cepiment/FisheriesNET/README.md

# FisheriesNET
Low Cost Solar Powered GPS Trackers
