cepiment/FisheriesNET/Schematics/LayoutView.PNG

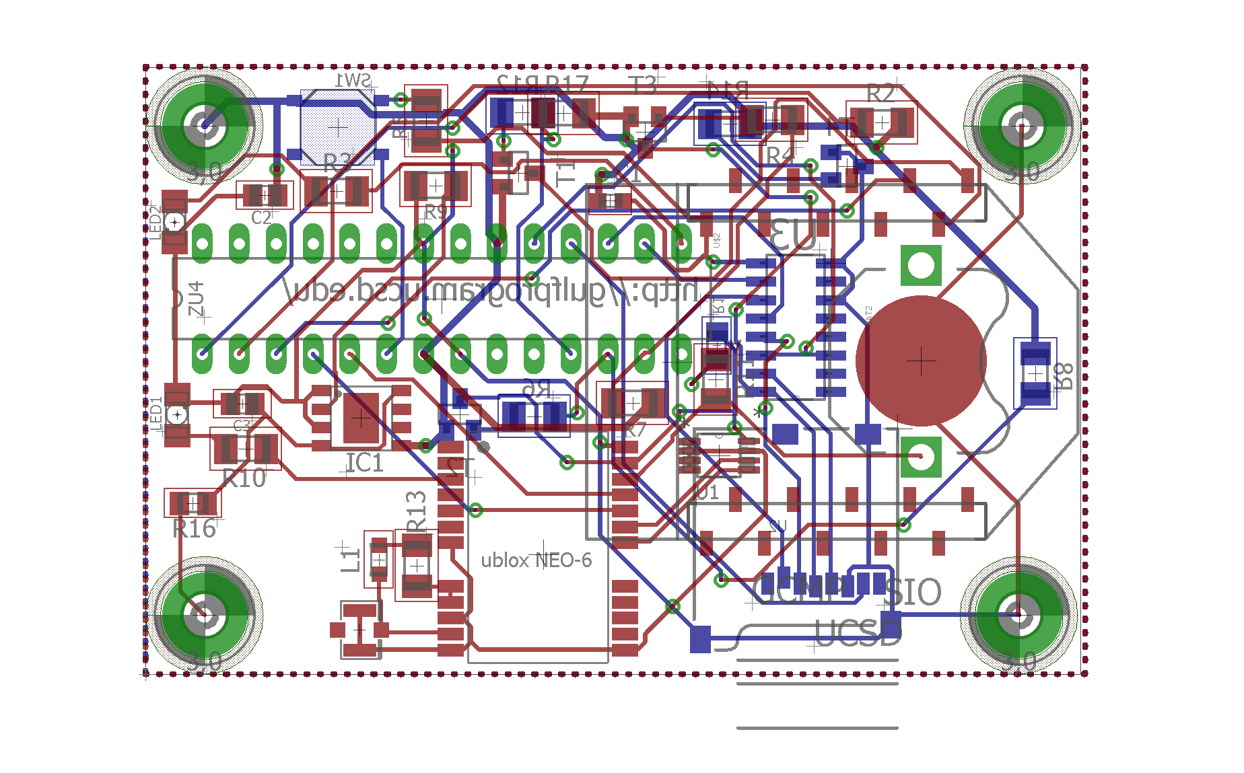
Schematics/LayoutView.PNG
