cepiment/FisheriesNET/Schematics/Schematic.PNG

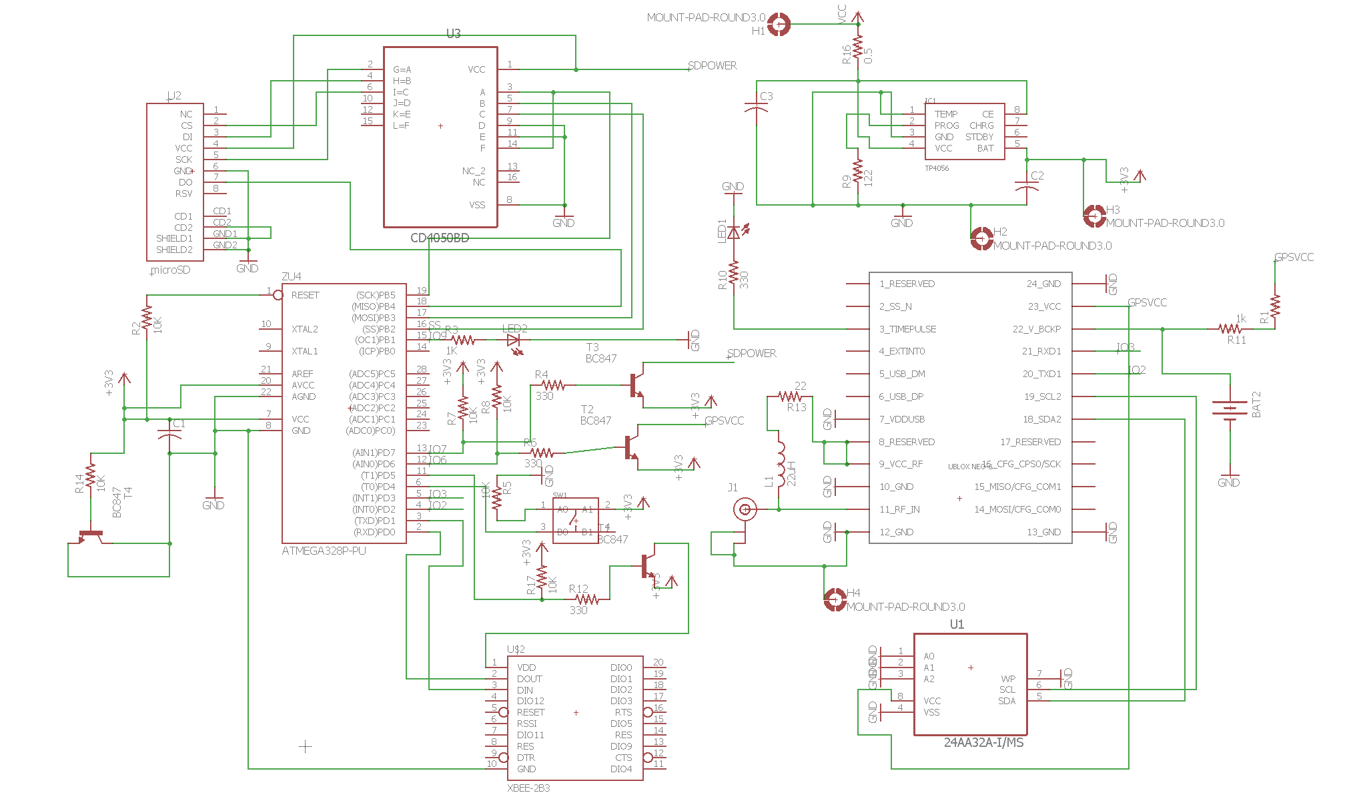
Schematics/Schematic.PNG
