cepiment/FisheriesNET/Schematics/janaury20.brd

## EAGLE design Schematics/janaury20.brd (2016-08-30)

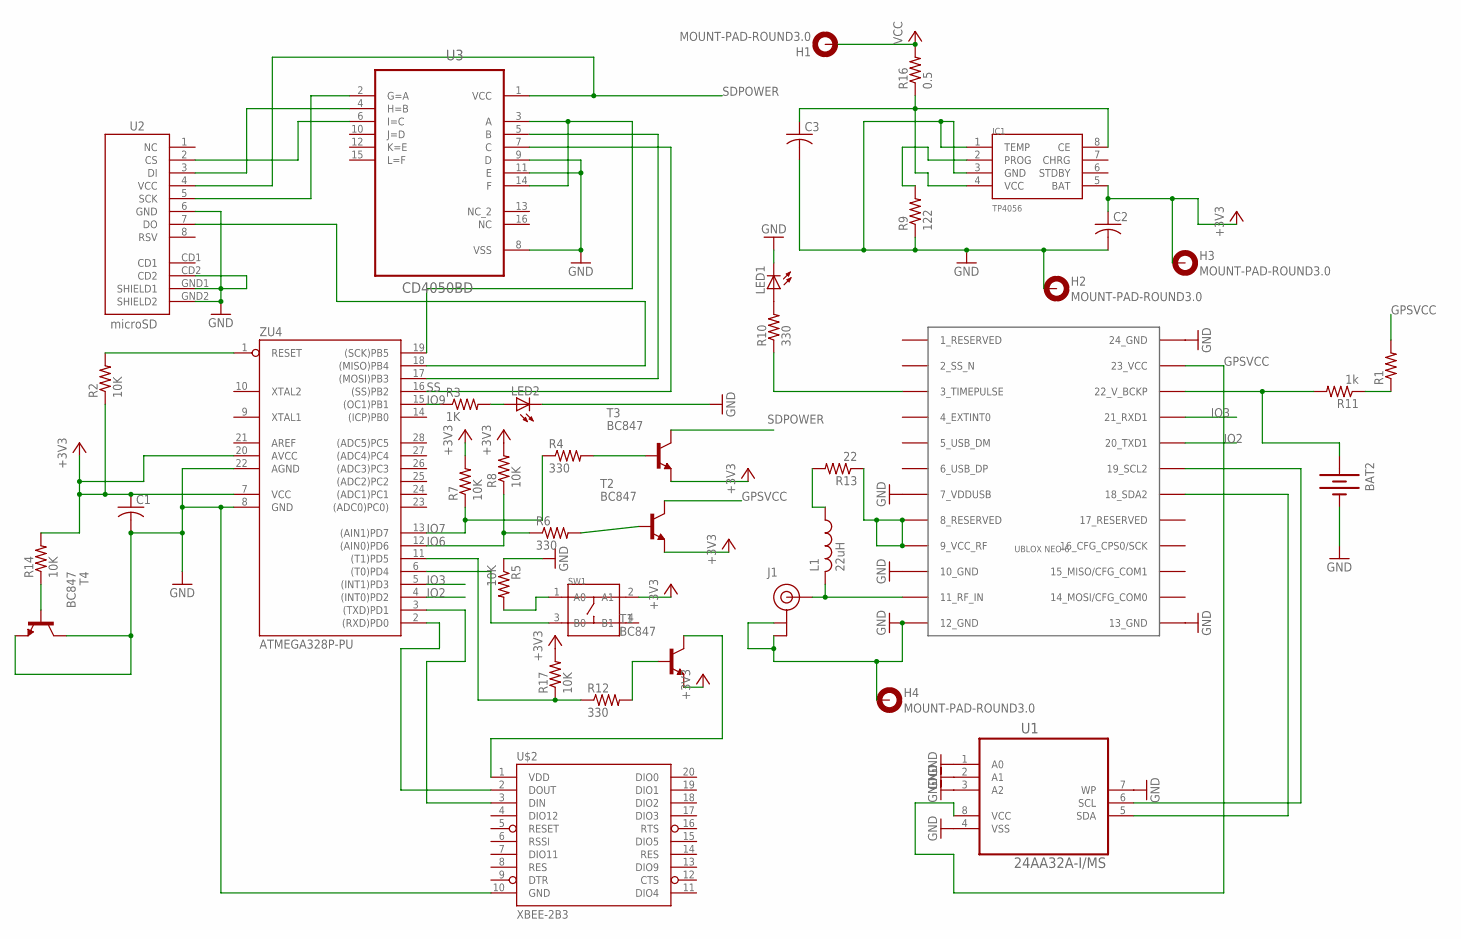
[picture p6: schematic janaury20.sch]

Parts:
BAT2: BATTERY12PTH; BATTCON_12MM_PTH
C1: C-USC1608; C1608
C2, C3: C-USC2012; C2012
H1, H2, H3, H4: MOUNT-PAD-ROUND3.0; 3,0-PAD
IC1: TP4056; SOP-8
J1: U.FL
L1: 22uH; L2012C
LED1, LED2: LEDSMT1206; 1206
R1: R-US_R0805; R0805
R2, R5, R7, R8, R14, R17: 10K; M3216
R3: 1K; M3216
R4, R6, R10, R12: 330; M3216
R9: 122; M3216
R11: 1k; M3216
R13: 22; M3216
R16: 0.5; M2012
SW1: SMD-BUTTON(4P-5.2X5.2X1.5MM-SKQGAKE010)-SKQGAKE010; SW4-SMD-5.2X5.2X1.5MM
T1, T2, T3, T4: BC847; SOT23
U1: 24AA32A-I/MS; SOP65P490X110-8N
U2: microSD; MICRO-SD-SOCKET-PP
U3: CD4050BD; SOIC127P600X175-16N
U$1: UBLOX_NEO-6; UBLOX_NEO-6P
U$2: XBEE-2B3; XBEE-SMD
ZU4: ATMEGA328P-PU; DIL28-3

Connections:
+3V3: C1.1, C2.1, H3.B3,0, IC1.5 (BAT), R2.1, R7.2, R8.2, R14.2, R17.2, SW1.2 (A1), T1.2 (E), T2.2 (E), T3.2 (E), ZU4.7 (VCC), ZU4.20 (AVCC)
CS: U2.2 (CS), U3.6 (I=C)
GND: BAT2.GND (-), C1.2, C2.2, C3.2, H2.B3,0, H4.B3,0, IC1.1 (TEMP), IC1.3 (GND), J1.P$1 (GND), J1.P$2 (GND), LED1.C, LED2.C, R5.1, R9.1, T4.2 (E), T4.3 (C), U1.1 (A0), U1.2 (A1), U1.3 (A2), U1.4 (VSS), U1.7 (WP), U2.6 (GND), U2.CD2, U2.GND1 (SHIELD1), U2.GND2 (SHIELD2), U3.8 (VSS), U3.9 (D), U3.11 (E), U$1.7_VDDUSB, U$1.10_GND, U$1.12_GND, U$1.13_GND, U$1.24_GND, U$2.10 (GND), ZU4.8 (GND), ZU4.22 (AGND)
GPSVCC: R1.2, T2.3 (C), U1.8 (VCC), U$1.23_VCC
IO2: U$1.20_TXD1, ZU4.4 ((INT0)PD2)
IO3: U$1.21_RXD1, ZU4.5 ((INT1)PD3)
IO6: R6.1, R8.1, ZU4.12 ((AIN0)PD6)
IO7: R4.1, R7.1, ZU4.13 ((AIN1)PD7)
IO9: R3.1, ZU4.15 ((OC1)PB1)
MOSI: U3.5 (B), ZU4.17 ((MOSI)PB3)
unnamed: U2.7 (DO), ZU4.18 ((MISO)PB4)
unnamed: LED2.A, R3.2
unnamed: LED1.A, R10.2
unnamed: R5.2, SW1.1 (A0)
unnamed: SW1.3 (B0), ZU4.6 ((T0)PD4)
unnamed: R4.2, T3.1 (B)
unnamed: R6.2, T2.1 (B)
unnamed: U1.6 (SCL), U$1.19_SCL2
unnamed: R12.1, R17.1, ZU4.11 ((T1)PD5)
unnamed: L1.1, R13.2
unnamed: U2.3 (DI), U3.4 (H=B)
unnamed: R12.2, T1.1 (B)
unnamed: R13.1, U$1.8_RESERVED, U$1.9_VCC_RF
unnamed: R14.1, T4.1 (B)
unnamed: J1.P$3 (SIGNAL), L1.2, U$1.11_RF_IN
unnamed: BAT2.VCC@1 (+), R11.2, U$1.22_V_BCKP
unnamed: U1.5 (SDA), U$1.18_SDA2
unnamed: R1.1, R11.1
unnamed: IC1.2 (PROG), R9.2
unnamed: U$2.2 (DOUT), ZU4.2 ((RXD)PD0)
unnamed: U$2.3 (DIN), ZU4.3 ((TXD)PD1)
unnamed: C3.1, IC1.4 (VCC), IC1.8 (CE), R16.1
unnamed: T1.3 (C), U$2.1 (VDD)
RESET: R2.2, ZU4.1 (RESET)
SCK: U3.3 (A), U3.14 (F), ZU4.19 ((SCK)PB5)
SCK1: U2.5 (SCK), U3.2 (G=A)
SCK2: R10.1, U$1.3_TIMEPULSE
SDPOWER: T3.3 (C), U2.4 (VCC), U3.1 (VCC)
SS: U3.7 (C), ZU4.16 ((SS)PB2)
VCC: H1.B3,0, R16.2

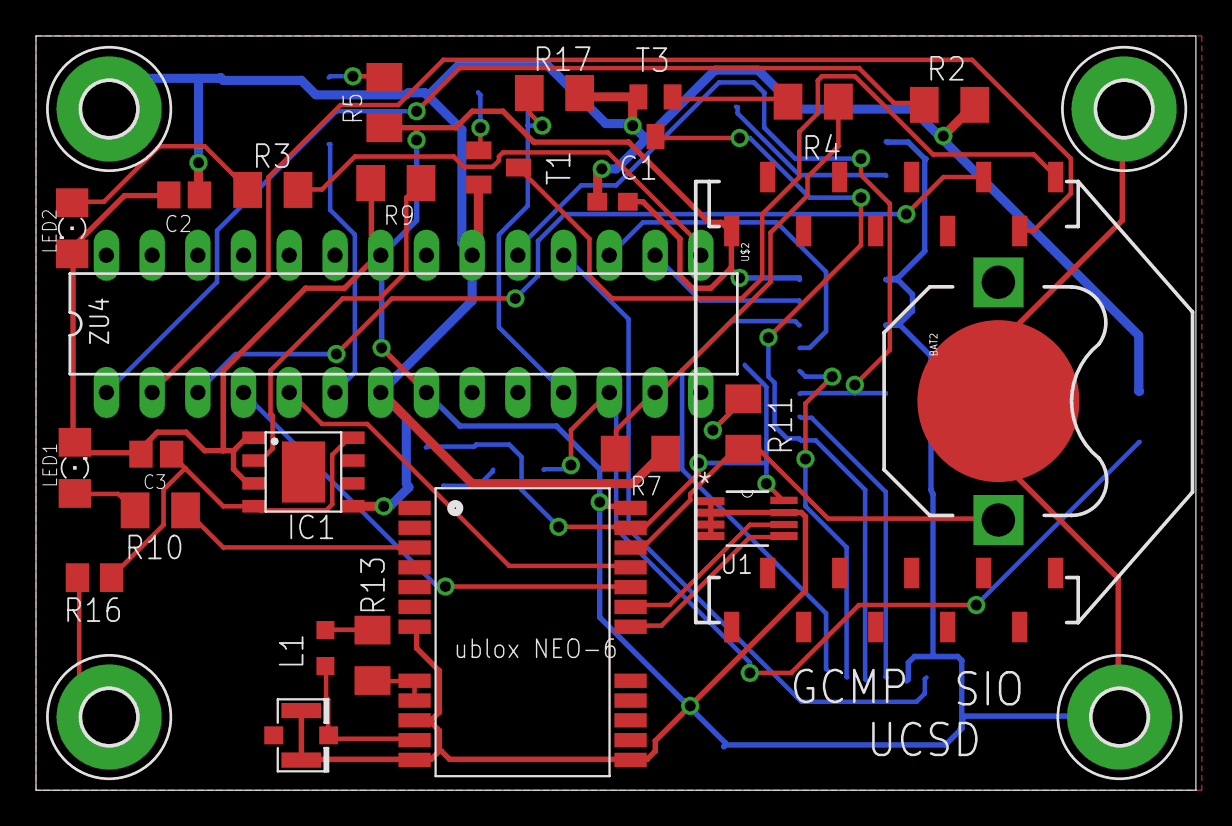
[picture p7: board janaury20.brd from above]

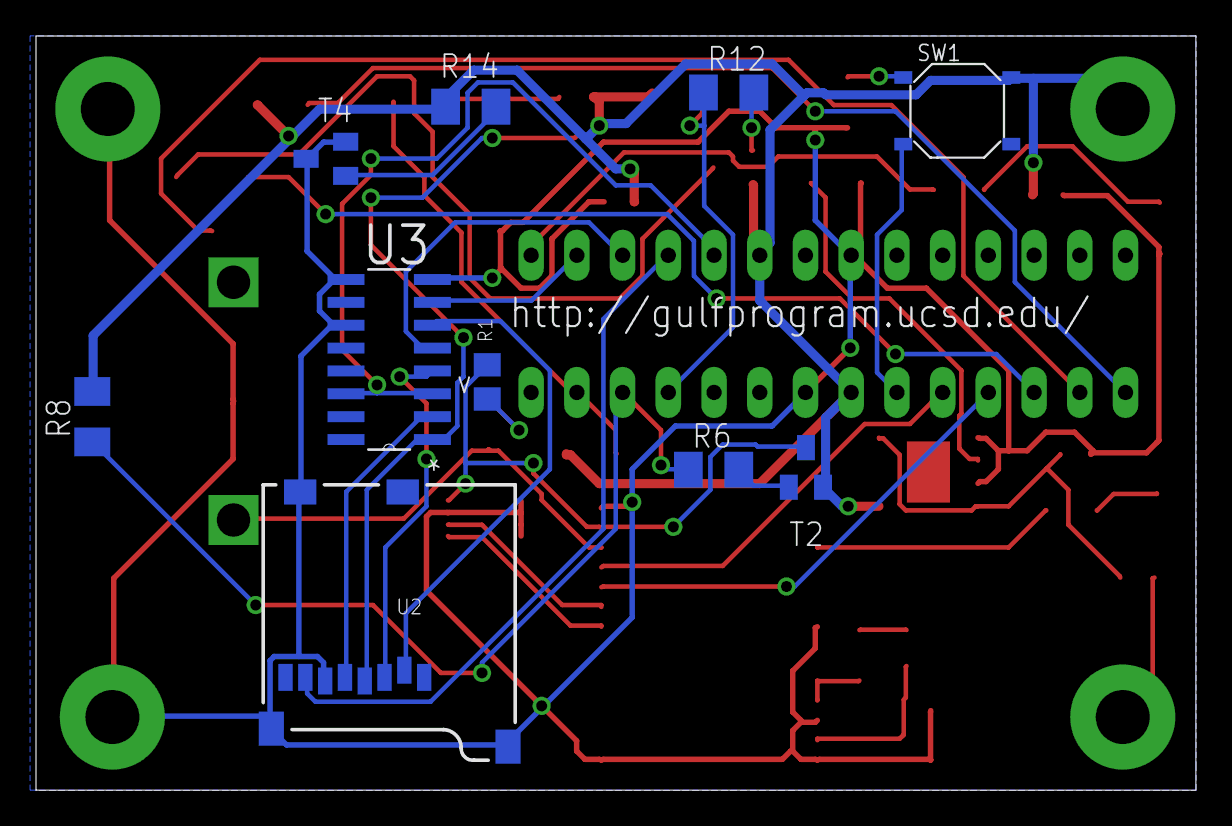
[picture p8: board janaury20.brd from below]

Board: 2 copper layers, 64.4 x 41.9 mm, 40 parts (10 on the bottom side), 40 nets.
