cepiment/FisheriesNET/MATLAB/TestData.csv

date/time | latitude | longitude | speed | trip | distance | boat
6:47:39 AM | 31.679232 | -114.49386 | 6.99 | 0 | 158.3 | GPS_20120105_134729
6:47:49 AM | 31.678552 | -114.493547 | 8.89 | 0 | 157 | GPS_20120105_134729
6:47:59 AM | 31.677742 | -114.49339 | 9.76 | 0 | 195.2 | GPS_20120105_134729
6:48:09 AM | 31.677147 | -114.493757 | 5.07 | 0 | 205.6 | GPS_20120105_134729
6:48:19 AM | 31.676678 | -114.494 | 5.78 | 0 | 210.3 | GPS_20120105_134729
6:48:29 AM | 31.67632 | -114.494318 | 5.65 | 0 | 218.6 | GPS_20120105_134729
6:48:39 AM | 31.675868 | -114.494907 | 8.67 | 0 | 227.4 | GPS_20120105_134729
6:48:49 AM | 31.675222 | -114.495493 | 8.86 | 0 | 215.5 | GPS_20120105_134729
6:48:59 AM | 31.674918 | -114.495943 | 2.59 | 0 | 299.4 | GPS_20120105_134729
6:49:09 AM | 31.674872 | -114.495892 | 2.52 | 0 | 162.6 | GPS_20120105_134729
6:49:19 AM | 31.674732 | -114.495923 | 1.56 | 0 | 197.9 | GPS_20120105_134729
6:49:29 AM | 31.674663 | -114.495955 | 0.61 | 0 | 197.6 | GPS_20120105_134729
6:49:39 AM | 31.674625 | -114.49597 | 0.38 | 0 | 202.7 | GPS_20120105_134729
6:49:49 AM | 31.674595 | -114.495982 | 0.29 | 0 | 203 | GPS_20120105_134729
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
